roboticist-blip/FedVibroSense_STM32/Hardware/PCB_FedVibroSense_STM32.pdf

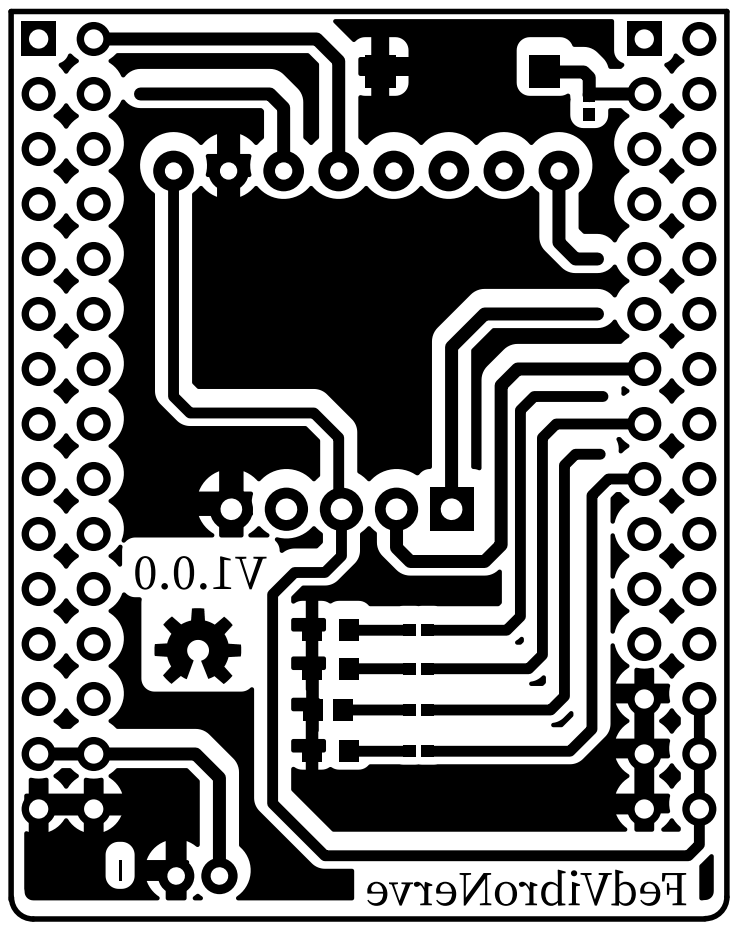
[picture p1: page 1]
