roboticist-blip/FedVibroSense_STM32/Hardware/Schematic_FedVibroSense_STM32.pdf

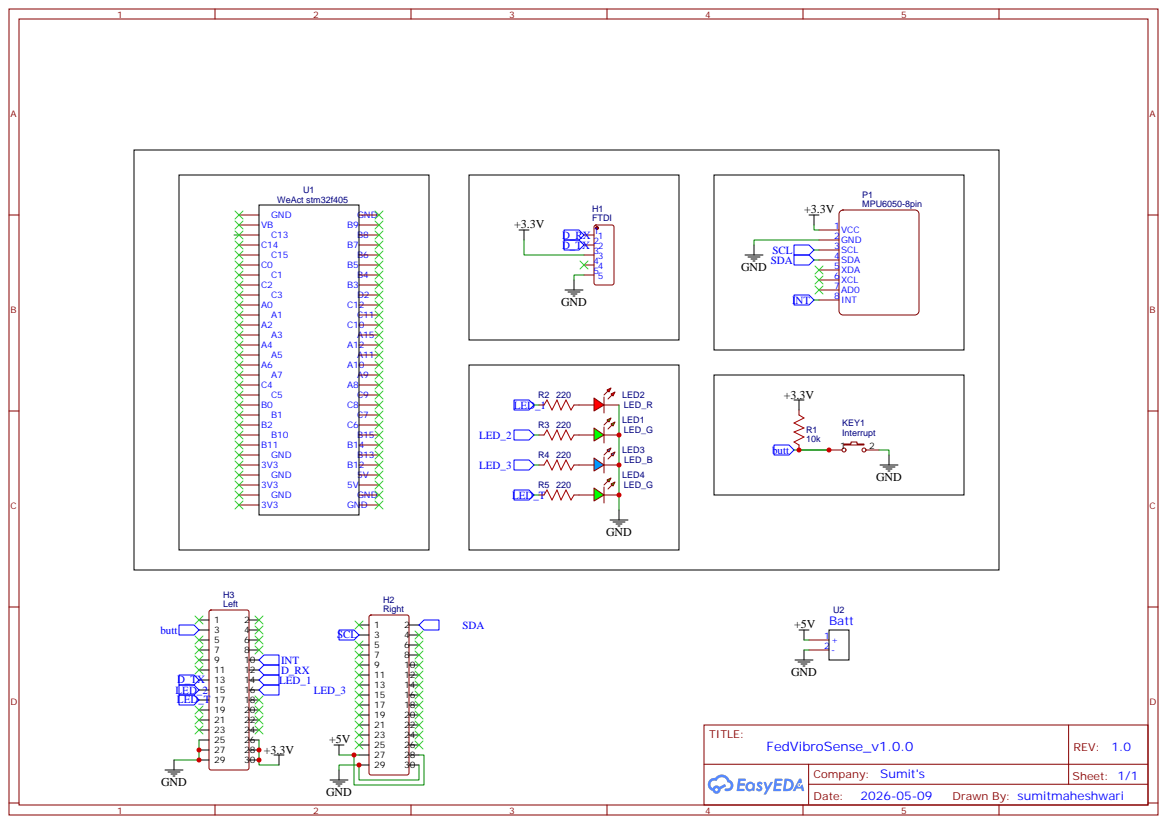
[picture p2: page 1]
