roboticist-blip/FedVibroSense_STM32/Core/Src/MPU6050.c

/**
 * @file    MPU6050.c
 * @brief   MPU-6050 IMU driver implementation for STM32F405 (HAL I2C)
 *
 * All I2C transactions use HAL_I2C_Mem_Read / HAL_I2C_Mem_Write in
 * blocking mode with I2C_TIMEOUT_MS timeout.  DMA transfers are not
 * used here to keep the driver simple and deterministic; for higher
 * throughput (>1 kHz), switch to HAL_I2C_Mem_Read_DMA with a
 * completion callback.
 *
 * @author  FedVibroSense Project
 * @version 1.0.0
 */

#include "MPU6050.h"
#include "Utils.h"
#include <string.h>
#include <math.h>

/* =========================================================================
 * PRIVATE HELPER — single register write
 * ========================================================================= */

MPU6050_Status_t MPU6050_WriteReg(MPU6050_Handle_t *hnd, uint8_t reg, uint8_t data)
{
    HAL_StatusTypeDef ret = HAL_I2C_Mem_Write(
        hnd->hi2c,
        hnd->dev_addr,
        reg,
        I2C_MEMADD_SIZE_8BIT,
        &data,
        1U,
        I2C_TIMEOUT_MS
    );
    if (ret != HAL_OK) {
        LOG_ERR("MPU6050 WriteReg 0x%02X failed, HAL=%d", reg, (int)ret);
        return MPU6050_ERR_I2C;
    }
    return MPU6050_OK;
}

/* =========================================================================
 * PRIVATE HELPER — single register read
 * ========================================================================= */

MPU6050_Status_t MPU6050_ReadReg(MPU6050_Handle_t *hnd, uint8_t reg, uint8_t *data)
{
    HAL_StatusTypeDef ret = HAL_I2C_Mem_Read(
        hnd->hi2c,
        hnd->dev_addr,
        reg,
        I2C_MEMADD_SIZE_8BIT,
        data,
        1U,
        I2C_TIMEOUT_MS
    );
    if (ret != HAL_OK) {
        LOG_ERR("MPU6050 ReadReg 0x%02X failed, HAL=%d", reg, (int)ret);
        return MPU6050_ERR_I2C;
    }
    return MPU6050_OK;
}

/* =========================================================================
 * INITIALIZATION
 * ========================================================================= */

/**
 * @brief  Full MPU-6050 initialization sequence.
 *
 * Step-by-step register configuration:
 *
 *  1. WHO_AM_I verification — abort if device not responding.
 *  2. PWR_MGMT_1 = 0x80 → device reset, wait 100 ms.
 *  3. PWR_MGMT_1 = 0x01 → wake up, select PLL + X-gyro clock (recommended
 *                          by InvenSense for better stability than internal osc).
 *  4. SMPLRT_DIV — set sample rate: SR = Gyro_SR / (1 + DIV)
 *                  Gyro_SR = 1 kHz when DLPF active.
 *                  For 100 Hz: DIV = 1000/100 - 1 = 9.
 *  5. CONFIG     — set DLPF_CFG per MPU6050_DLPF_CFG (44 Hz bandwidth).
 *  6. GYRO_CONFIG  — set FS_SEL per MPU6050_GYRO_FS.
 *  7. ACCEL_CONFIG — set AFS_SEL per MPU6050_ACCEL_FS.
 *  8. INT_ENABLE = 0x01 → DATA_RDY_EN (fires INT pin every sample).
 *  9. INT_PIN_CFG = 0x02 → INT pin active-low, push-pull, latch until read.
 */
MPU6050_Status_t MPU6050_Init(MPU6050_Handle_t *hnd, I2C_HandleTypeDef *hi2c)
{
    MPU6050_Status_t status;
    uint8_t val;

    /* Store handle parameters */
    hnd->hi2c      = hi2c;
    hnd->dev_addr  = MPU6050_I2C_ADDR_SHIFTED;
    hnd->initialized = 0U;
    hnd->gyro_bias_x = 0.0f;
    hnd->gyro_bias_y = 0.0f;
    hnd->gyro_bias_z = 0.0f;
    hnd->accel_bias_x = 0.0f;
    hnd->accel_bias_y = 0.0f;
    hnd->data_ready_flag = 0U;

    /* --- Step 1: WHO_AM_I verification ---------------------------------- */
    status = MPU6050_ReadReg(hnd, MPU6050_REG_WHO_AM_I, &val);
    if (status != MPU6050_OK) return status;

    if (val != MPU6050_WHO_AM_I_VAL) {
        LOG_ERR("MPU6050 WHO_AM_I mismatch: got 0x%02X, expected 0x%02X",
                val, MPU6050_WHO_AM_I_VAL);
        return MPU6050_ERR_WHO_AM_I;
    }
    LOG_INF("MPU6050 WHO_AM_I OK (0x%02X)", val);

    /* --- Step 2: Device reset ------------------------------------------- */
    status = MPU6050_WriteReg(hnd, MPU6050_REG_PWR_MGMT_1, 0x80U);
    if (status != MPU6050_OK) return status;
    HAL_Delay(100U);   /* Wait for reset to complete */

    /* --- Step 3: Wake up, select PLL + X-gyro clock --------------------- */
    status = MPU6050_WriteReg(hnd, MPU6050_REG_PWR_MGMT_1, 0x01U);
    if (status != MPU6050_OK) return status;
    HAL_Delay(10U);

    /* --- Step 4: Sample rate divider (DIV=9 → 100 Hz) ------------------- */
    /* SR = 1000 / (1 + SMPLRT_DIV) when DLPF enabled */
    uint8_t smplrt_div = (uint8_t)(1000U / IMU_SAMPLE_RATE_HZ - 1U);
    status = MPU6050_WriteReg(hnd, MPU6050_REG_SMPLRT_DIV, smplrt_div);
    if (status != MPU6050_OK) return status;

    /* --- Step 5: Digital Low-Pass Filter configuration ------------------ */
    status = MPU6050_WriteReg(hnd, MPU6050_REG_CONFIG,
                              (uint8_t)(MPU6050_DLPF_CFG & 0x07U));
    if (status != MPU6050_OK) return status;

    /* --- Step 6: Gyroscope full-scale range ----------------------------- */
    /* FS_SEL bits [4:3] in GYRO_CONFIG register */
    status = MPU6050_WriteReg(hnd, MPU6050_REG_GYRO_CONFIG,
                              (uint8_t)((MPU6050_GYRO_FS & 0x03U) << 3U));
    if (status != MPU6050_OK) return status;

    /* --- Step 7: Accelerometer full-scale range ------------------------- */
    /* AFS_SEL bits [4:3] in ACCEL_CONFIG register */
    status = MPU6050_WriteReg(hnd, MPU6050_REG_ACCEL_CONFIG,
                              (uint8_t)((MPU6050_ACCEL_FS & 0x03U) << 3U));
    if (status != MPU6050_OK) return status;

    /* --- Step 8: Enable DATA_RDY interrupt ------------------------------ */
    status = MPU6050_WriteReg(hnd, MPU6050_REG_INT_ENABLE, 0x01U);
    if (status != MPU6050_OK) return status;

    /* --- Step 9: INT pin config: active-low, push-pull, latch-until-read */
    /* Bit 7: INT_LEVEL=1 (active low), Bit 5: LATCH_INT_EN=1 */
    status = MPU6050_WriteReg(hnd, MPU6050_REG_INT_PIN_CFG, 0xA0U);
    if (status != MPU6050_OK) return status;

    hnd->initialized = 1U;
    LOG_INF("MPU6050 init OK — FS_accel=%dg, FS_gyro=%d°/s, SR=%dHz",
            (2 << MPU6050_ACCEL_FS),
            (250 << MPU6050_GYRO_FS),
            IMU_SAMPLE_RATE_HZ);

    return MPU6050_OK;
}

/* =========================================================================
 * CALIBRATION
 * ========================================================================= */

/**
 * @brief  Collect MPU6050_CALIBRATION_SAMPLES samples at rest and compute
 *         mean gyroscope bias for each axis.  Also checks accel Z ≈ 1g
 *         to confirm horizontal orientation.
 *
 * The device MUST be completely stationary during calibration.
 * Typical duration: 200 samples × 10 ms period = 2 seconds.
 */
MPU6050_Status_t MPU6050_Calibrate(MPU6050_Handle_t *hnd)
{
    if (!hnd->initialized) return MPU6050_ERR_NOTINIT;

    MPU6050_RawData_t raw;
    MPU6050_Status_t  status;

    double sum_gx = 0.0, sum_gy = 0.0, sum_gz = 0.0;
    double sum_ax = 0.0, sum_ay = 0.0;

    LOG_INF("MPU6050 calibration: collecting %u samples...",
            MPU6050_CALIBRATION_SAMPLES);

    for (uint32_t i = 0U; i < MPU6050_CALIBRATION_SAMPLES; i++) {
        status = MPU6050_ReadRaw(hnd, &raw);
        if (status != MPU6050_OK) return status;

        sum_gx += (double)raw.gyro_x;
        sum_gy += (double)raw.gyro_y;
        sum_gz += (double)raw.gyro_z;
        sum_ax += (double)raw.accel_x;
        sum_ay += (double)raw.accel_y;

        /* Wait for next sample period */
        HAL_Delay(1000U / IMU_SAMPLE_RATE_HZ);
    }

    /* Compute mean raw gyro bias and convert to °/s */
    double n = (double)MPU6050_CALIBRATION_SAMPLES;
    hnd->gyro_bias_x = (float)((sum_gx / n) / MPU6050_GYRO_SENSITIVITY);
    hnd->gyro_bias_y = (float)((sum_gy / n) / MPU6050_GYRO_SENSITIVITY);
    hnd->gyro_bias_z = (float)((sum_gz / n) / MPU6050_GYRO_SENSITIVITY);

    /* Optional: accel X/Y bias (sensor should read 0g on these axes) */
    hnd->accel_bias_x = (float)((sum_ax / n) / MPU6050_ACCEL_SENSITIVITY *
                                 GRAVITY_MSS);
    hnd->accel_bias_y = (float)((sum_ay / n) / MPU6050_ACCEL_SENSITIVITY *
                                 GRAVITY_MSS);

    LOG_INF("Gyro bias: X=%.4f Y=%.4f Z=%.4f °/s",
            (double)hnd->gyro_bias_x,
            (double)hnd->gyro_bias_y,
            (double)hnd->gyro_bias_z);
    LOG_INF("Accel bias: X=%.4f Y=%.4f m/s²",
            (double)hnd->accel_bias_x,
            (double)hnd->accel_bias_y);

    return MPU6050_OK;
}

/* =========================================================================
 * BURST READ — 14 BYTES
 * ========================================================================= */

/**
 * @brief  Read all 7 sensor words (14 bytes) in a single I2C transaction.
 *
 * Starting from ACCEL_XOUT_H (0x3B), the MPU-6050 auto-increments the
 * register pointer through:
 *   0x3B ACCEL_XOUT_H
 *   0x3C ACCEL_XOUT_L
 *   0x3D ACCEL_YOUT_H
 *   0x3E ACCEL_YOUT_L
 *   0x3F ACCEL_ZOUT_H
 *   0x40 ACCEL_ZOUT_L
 *   0x41 TEMP_OUT_H
 *   0x42 TEMP_OUT_L
 *   0x43 GYRO_XOUT_H
 *   0x44 GYRO_XOUT_L
 *   0x45 GYRO_YOUT_H
 *   0x46 GYRO_YOUT_L
 *   0x47 GYRO_ZOUT_H
 *   0x48 GYRO_ZOUT_L
 *
 * Big-endian reconstruction: value = (HIGH << 8) | LOW
 */
MPU6050_Status_t MPU6050_ReadRaw(MPU6050_Handle_t *hnd, MPU6050_RawData_t *raw)
{
    if (!hnd->initialized) return MPU6050_ERR_NOTINIT;

    uint8_t buf[14];

    HAL_StatusTypeDef ret = HAL_I2C_Mem_Read(
        hnd->hi2c,
        hnd->dev_addr,
        MPU6050_REG_ACCEL_XOUT_H,
        I2C_MEMADD_SIZE_8BIT,
        buf,
        14U,
        I2C_TIMEOUT_MS
    );

    if (ret != HAL_OK) {
        LOG_ERR("MPU6050 burst read failed, HAL=%d", (int)ret);
        return MPU6050_ERR_I2C;
    }

    /* Big-endian 16-bit reconstruction */
    raw->accel_x = (int16_t)((uint16_t)(buf[0]  << 8U) | buf[1]);
    raw->accel_y = (int16_t)((uint16_t)(buf[2]  << 8U) | buf[3]);
    raw->accel_z = (int16_t)((uint16_t)(buf[4]  << 8U) | buf[5]);
    raw->temp    = (int16_t)((uint16_t)(buf[6]  << 8U) | buf[7]);
    raw->gyro_x  = (int16_t)((uint16_t)(buf[8]  << 8U) | buf[9]);
    raw->gyro_y  = (int16_t)((uint16_t)(buf[10] << 8U) | buf[11]);
    raw->gyro_z  = (int16_t)((uint16_t)(buf[12] << 8U) | buf[13]);

    return MPU6050_OK;
}

/* =========================================================================
 * UNIT CONVERSION
 * ========================================================================= */

/**
 * @brief  Convert raw ADC counts to physical SI units.
 *
 * Accelerometer:
 *   raw_count / ACCEL_SENSITIVITY [LSB/g] × GRAVITY_MSS [m/s²/g] = m/s²
 *
 * Gyroscope:
 *   raw_count / GYRO_SENSITIVITY [LSB/°/s] - bias = °/s
 *
 * Temperature:
 *   (raw_count / 340.0) + 36.53 = °C  (from MPU-6050 datasheet §4.18)
 */
void MPU6050_ConvertToPhysical(const MPU6050_Handle_t *hnd,
                                const MPU6050_RawData_t *raw,
                                MPU6050_Data_t *out)
{
    /* Accelerometer: raw → m/s² */
    out->ax = ((float)raw->accel_x / MPU6050_ACCEL_SENSITIVITY) * GRAVITY_MSS
              - hnd->accel_bias_x;
    out->ay = ((float)raw->accel_y / MPU6050_ACCEL_SENSITIVITY) * GRAVITY_MSS
              - hnd->accel_bias_y;
    out->az = ((float)raw->accel_z / MPU6050_ACCEL_SENSITIVITY) * GRAVITY_MSS;
    /* Note: az bias not removed — vertical axis includes gravity by design */

    /* Gyroscope: raw → °/s with bias compensation */
    out->gx = ((float)raw->gyro_x / MPU6050_GYRO_SENSITIVITY)
              - hnd->gyro_bias_x;
    out->gy = ((float)raw->gyro_y / MPU6050_GYRO_SENSITIVITY)
              - hnd->gyro_bias_y;
    out->gz = ((float)raw->gyro_z / MPU6050_GYRO_SENSITIVITY)
              - hnd->gyro_bias_z;

    /* Temperature: raw → °C */
    out->temp_c = ((float)raw->temp / 340.0f) + 36.53f;
}

/* =========================================================================
 * COMBINED READ + CONVERT
 * ========================================================================= */

MPU6050_Status_t MPU6050_ReadScaled(MPU6050_Handle_t *hnd, MPU6050_Data_t *out)
{
    MPU6050_RawData_t raw;
    MPU6050_Status_t  status = MPU6050_ReadRaw(hnd, &raw);
    if (status != MPU6050_OK) return status;
    MPU6050_ConvertToPhysical(hnd, &raw, out);
    return MPU6050_OK;
}

/* =========================================================================
 * INTERRUPT CALLBACK
 * ========================================================================= */

/**
 * @brief  Called from HAL_GPIO_EXTI_Callback when MPU-6050 INT fires.
 *
 * This is an ISR context — keep it minimal.  Only sets the flag;
 * the main loop polls MPU6050_IsDataReady() and calls ReadScaled().
 */
void MPU6050_DataReadyISR(MPU6050_Handle_t *hnd)
{
    hnd->data_ready_flag = 1U;
}
