roboticist-blip/FedVibroSense_STM32/(commit log)

2026-05-08 Initial STM32 federated sensing firmware
2026-05-08 Change LED status pins from PD to PA
    Updated LED status output to use GPIOA pins instead of GPIOD pins.
2026-05-09 Schematic of V1.0.0
2026-05-09 PCB design for single sided Etching
